MichalBlk/vvsoc/hw/top.sv

`include "isa.svh"
`include "evdev.svh"
`include "soc.svh"

module top
  import isa_pkg::*;
  import evdev_pkg::*;
  import param_pkg::*;
  import soc_pkg::*;
  import board_pkg::*;
(
  input  logic                      clk,
  input  logic                      vga_clk,
  input  logic                      nrst,

`ifdef NEXYS_A7
  input  logic                      dram_clk,
  input  logic                      fl_clk,
  input  logic                      kbd_clk,

  inout  logic [DDR2_DQLEN - 1:0]   ddr2_dq,
  inout  logic [DDR2_DQSLEN - 1:0]  ddr2_dqs_n,
  inout  logic [DDR2_DQSLEN - 1:0]  ddr2_dqs_p,
  output logic [DDR2_ADDRLEN - 1:0] ddr2_addr,
  output logic [DDR2_BALEN - 1:0]   ddr2_ba,
  output logic                      ddr2_ras_n,
  output logic                      ddr2_cas_n,
  output logic                      ddr2_we_n,
  output logic                      ddr2_ck_p,
  output logic                      ddr2_ck_n,
  output logic                      ddr2_cke,
  output logic                      ddr2_cs_n,
  output logic [DDR2_DMLEN - 1:0]   ddr2_dm,
  output logic                      ddr2_odt,

  input  logic                      fl_miso,
  output logic                      fl_mosi,
  output logic                      fl_sclk,
  output logic                      fl_ncs,

  input  logic                      kbd_data,
`endif

  input  logic                      rx,
  output logic                      tx,

  output logic [VGA_POSLEN - 1:0]   x,
  output logic [VGA_POSLEN - 1:0]   y,
  output logic [VGA_COLORLEN - 1:0] r,
  output logic [VGA_COLORLEN - 1:0] g,
  output logic [VGA_COLORLEN - 1:0] b,
  output logic                      hsync,
  output logic                      vsync
);
`default_nettype none

  logic [XLEN - 1:0]             bmem_asw_rdata;
  logic                          bmem_asw_stall;

  logic                          dbgc_asw_stall;
  logic [BLEN - 1:0]             dbgc_vmgr_byte;
  logic                          dbgc_vmgr_wen;

  logic [XLEN - 1:0]             clint_asw_rdata;
  logic [CNTLEN - 1:0]           clint_ac_mtime;
  logic                          clint_ac_intr_pending;

  logic [XLEN - 1:0]             fl_asw_rdata;
  logic                          fl_asw_stall;

  logic [XLEN - 1:0]             ac_asw_addr;
  logic [XLEN - 1:0]             ac_asw_wdata;
  logic [XLENB_LOG - 1:0]        ac_asw_size;
  logic                          ac_asw_nsign;
  logic                          ac_asw_ren;
  logic                          ac_asw_wen;

  logic [XLEN - 1:0]             asw_ac_rdata;
  logic                          asw_ac_stall;
  logic                          asw_ac_fault;
  logic [VCD_ADDRLEN - 1:0]      asw_vcd_addr;
  logic [XLEN - 1:0]             asw_vcd_wdata;
  logic                          asw_vcd_wen;
  logic [VGD_ADDRLEN - 1:0]      asw_vgd_addr;
  logic [XLEN - 1:0]             asw_vgd_wdata;
  logic                          asw_vgd_wen;
  logic [VKD_ADDRLEN - 1:0]      asw_vkd_addr;
  logic [XLEN - 1:0]             asw_vkd_wdata;
  logic                          asw_vkd_wen;
  logic [BMEM_ADDRLEN - 1:0]     asw_bmem_addr;
  logic [XLEN - 1:0]             asw_bmem_wdata;
  logic [XLENB_LOG - 1:0]        asw_bmem_size;
  logic                          asw_bmem_nsign;
  logic                          asw_bmem_ren;
  logic                          asw_bmem_wen;
  logic [BLEN - 1:0]             asw_dbgc_wdata;
  logic                          asw_dbgc_wen;
  logic [CLINT_ADDRLEN - 1:0]    asw_clint_addr;
  logic [XLEN - 1:0]             asw_clint_wdata;
  logic                          asw_clint_wen;
  logic [FL_ADDRLEN - 1:0]       asw_fl_addr;
  logic                          asw_fl_nsign;
  logic                          asw_fl_ren;
  logic [XLEN - 1:0]             asw_msw_addr;
  logic [XLEN - 1:0]             asw_msw_wdata;
  logic [XLENB_LOG - 1:0]        asw_msw_size;
  logic                          asw_msw_nsign;
  logic                          asw_msw_ren;
  logic                          asw_msw_wen;

  logic [XLEN - 1:0]             msw_asw_rdata;
  logic                          msw_asw_stall;
  logic [XLEN - 1:0]             msw_vsw_rdata;
  logic                          msw_vsw_stall;
  logic [MMEM_ADDRLEN - 1:0]     msw_cache_addr;
  logic [XLEN - 1:0]             msw_cache_wdata;
  logic [XLENB_LOG - 1:0]        msw_cache_size;
  logic                          msw_cache_nsign;
  logic                          msw_cache_ren;
  logic                          msw_cache_wen;

  logic [XLEN - 1:0]             cache_ac_pte;
  logic [CACHE_LINELEN - 1:0]    cache_ac_line;
  logic [XLEN - 1:0]             cache_msw_rdata;
  logic                          cache_msw_release;
  logic                          cache_msw_done;
  logic [MMEM_ADDRLEN - 1:0]     cache_mmem_addr;
  logic [MMEM_DATALEN - 1:0]     cache_mmem_wdata;
  logic                          cache_mmem_ren;
  logic                          cache_mmem_wen;

  logic [MMEM_DATALEN - 1:0]     mmem_cache_rdata;
  logic                          mmem_cache_stall;

  logic                          vcd_ac_intr_pending;
  logic [XLEN - 1:0]             vcd_asw_rdata;
  logic                          vcd_asw_stall;
  logic [XLEN - 1:0]             vcd_vsw_rdata;
  logic [VCD_QUEUECNT - 1:0]     vcd_vmgr_queue_rdy;
  logic [VCD_QUEUECNT_LOG - 1:0] vcd_vmgr_queue_num;
  logic                          vcd_vmgr_notify;
  logic                          vcd_vmgr_drvok;

  logic                          vgd_ac_intr_pending;
  logic [XLEN - 1:0]             vgd_asw_rdata;
  logic                          vgd_asw_stall;
  logic [XLEN - 1:0]             vgd_vsw_rdata;
  logic [VGD_QUEUECNT - 1:0]     vgd_vmgr_queue_rdy;
  logic [VGD_QUEUECNT_LOG - 1:0] vgd_vmgr_queue_num;
  logic                          vgd_vmgr_notify;
  logic                          vgd_vmgr_drvok;

  logic                          vkd_ac_intr_pending;
  logic [XLEN - 1:0]             vkd_asw_rdata;
  logic                          vkd_asw_stall;
  logic [XLEN - 1:0]             vkd_vsw_rdata;
  logic [VKD_QUEUECNT - 1:0]     vkd_vmgr_queue_rdy;
  logic [VKD_QUEUECNT_LOG - 1:0] vkd_vmgr_queue_num;
  logic                          vkd_vmgr_notify;
  logic                          vkd_vmgr_drvok;

  logic [XLEN - 1:0]             vsw_vc_rdata;
  logic                          vsw_vc_stall;
  logic [VMEM_ADDRLEN - 1:0]     vsw_vmem_addr;
  logic [XLEN - 1:0]             vsw_vmem_wdata;
  logic [XLENB_LOG - 1:0]        vsw_vmem_size;
  logic                          vsw_vmem_nsign;
  logic                          vsw_vmem_ren;
  logic                          vsw_vmem_wen;
  logic [VMGR_ADDRLEN - 1:0]     vsw_vmgr_addr;
  logic [XLEN - 1:0]             vsw_vmgr_wdata;
  logic                          vsw_vmgr_ren;
  logic                          vsw_vmgr_wen;
  logic [VCD_ADDRLEN - 1:0]      vsw_vcd_addr;
  logic [XLEN - 1:0]             vsw_vcd_wdata;
  logic                          vsw_vcd_wen;
  logic [VGD_ADDRLEN - 1:0]      vsw_vgd_addr;
  logic [XLEN - 1:0]             vsw_vgd_wdata;
  logic                          vsw_vgd_wen;
  logic [VKD_ADDRLEN - 1:0]      vsw_vkd_addr;
  logic [XLEN - 1:0]             vsw_vkd_wdata;
  logic                          vsw_vkd_wen;
  logic [XLEN - 1:0]             vsw_msw_addr;
  logic [XLEN - 1:0]             vsw_msw_wdata;
  logic [XLENB_LOG - 1:0]        vsw_msw_size;
  logic                          vsw_msw_nsign;
  logic                          vsw_msw_ren;
  logic                          vsw_msw_wen;

  logic [XLEN - 1:0]             vc_vsw_addr;
  logic [XLEN - 1:0]             vc_vsw_wdata;
  logic [XLENB_LOG - 1:0]        vc_vsw_size;
  logic                          vc_vsw_nsign;
  logic                          vc_vsw_ren;
  logic                          vc_vsw_wen;

  logic                          vmgr_dbgc_stall;
  logic [BLEN - 1:0]             vmgr_uart_tx_byte;
  logic                          vmgr_uart_tx_start;
  logic [VGA_COLORLEN - 1:0]     vmgr_vga_r;
  logic [VGA_COLORLEN - 1:0]     vmgr_vga_g;
  logic [VGA_COLORLEN - 1:0]     vmgr_vga_b;
  logic [XLEN - 1:0]             vmgr_vsw_rdata;
  logic                          vmgr_vsw_stall;
  logic                          vmgr_vcd_used;
  logic                          vmgr_vgd_used;
  logic                          vmgr_vkd_used;

  logic [XLEN - 1:0]             vmem_vsw_rdata;
  logic                          vmem_vsw_stall;
  logic [XLEN - 1:0]             vmem_vc_raw_data;

  logic [BLEN - 1:0]             uart_vmgr_rx_byte;
  logic                          uart_vmgr_rx_ready;
  logic                          uart_vmgr_tx_busy;

  logic [VGA_FRAMESZ_LOG - 1:0]  vga_vmgr_pos;

  logic [EV_CODELEN - 1:0]       kbd_vmgr_code;
  logic                          kbd_vmgr_value;
  logic                          kbd_vmgr_ready;

  dbg_console DBG_CONSOLE(
    .clk        (clk),
    .asw_wdata  (asw_dbgc_wdata),
    .asw_wen    (asw_dbgc_wen),
    .asw_stall  (dbgc_asw_stall),
    .vmgr_byte  (dbgc_vmgr_byte),
    .vmgr_wen   (dbgc_vmgr_wen),
    .vmgr_stall (vmgr_dbgc_stall)
  );

  memory #(
    .SZ    (BMEMSZ),
    .MEM   ("bootloader.mem")
  ) BOOT_MEMORY(
    .clk      (clk),
    .nrst     (nrst),
    .addr     (asw_bmem_addr),
    .wdata    (asw_bmem_wdata),
    .size     (asw_bmem_size),
    .nsign    (asw_bmem_nsign),
    .ren      (asw_bmem_ren),
    .wen      (asw_bmem_wen),
    .raw_data (),
    .rdata    (bmem_asw_rdata),
    .stall    (bmem_asw_stall)
  );

  clint CLINT(
    .clk             (clk),
    .nrst            (nrst),
    .asw_addr        (asw_clint_addr),
    .asw_wdata       (asw_clint_wdata),
    .asw_wen         (asw_clint_wen),
    .asw_rdata       (clint_asw_rdata),
    .ac_mtime        (clint_ac_mtime),
    .ac_intr_pending (clint_ac_intr_pending)
  );

`ifdef SIM
  flash FLASH(
    .clk       (clk),
    .nrst      (nrst),
    .asw_addr  (asw_fl_addr),
    .asw_nsign (asw_fl_nsign),
    .asw_ren   (asw_fl_ren),
    .asw_rdata (fl_asw_rdata),
    .asw_stall (fl_asw_stall)
  );
`elsif NEXYS_A7
  flash FLASH(
    .clk       (clk),
    .fl_clk    (fl_clk),
    .nrst      (nrst),
    .asw_addr  (asw_fl_addr),
    .asw_nsign (asw_fl_nsign),
    .asw_ren   (asw_fl_ren),
    .asw_rdata (fl_asw_rdata),
    .asw_stall (fl_asw_stall),
    .miso      (fl_miso),
    .mosi      (fl_mosi),
    .sclk      (fl_sclk),
    .ncs       (fl_ncs)
  );
`endif

  app_core APP_CORE(
    .clk                (clk),
    .nrst               (nrst),
    .clint_mtime        (clint_ac_mtime),
    .clint_intr_pending (clint_ac_intr_pending),
    .asw_rdata          (asw_ac_rdata),
    .asw_stall          (asw_ac_stall),
    .asw_fault          (asw_ac_fault),
    .asw_addr           (ac_asw_addr),
    .asw_wdata          (ac_asw_wdata),
    .asw_size           (ac_asw_size),
    .asw_nsign          (ac_asw_nsign),
    .asw_ren            (ac_asw_ren),
    .asw_wen            (ac_asw_wen),
    .cache_pte          (cache_ac_pte),
    .cache_line         (cache_ac_line),
    .vcd_intr_pending   (vcd_ac_intr_pending),
    .vgd_intr_pending   (vgd_ac_intr_pending),
    .vkd_intr_pending   (vkd_ac_intr_pending)
  );

  app_switch APP_SWITCH(
    .ac_addr     (ac_asw_addr),
    .ac_wdata    (ac_asw_wdata),
    .ac_size     (ac_asw_size),
    .ac_nsign    (ac_asw_nsign),
    .ac_ren      (ac_asw_ren),
    .ac_wen      (ac_asw_wen),
    .ac_rdata    (asw_ac_rdata),
    .ac_stall    (asw_ac_stall),
    .ac_fault    (asw_ac_fault),
    .vcd_rdata   (vcd_asw_rdata),
    .vcd_stall   (vcd_asw_stall),
    .vcd_addr    (asw_vcd_addr),
    .vcd_wdata   (asw_vcd_wdata),
    .vcd_wen     (asw_vcd_wen),
    .vgd_rdata   (vgd_asw_rdata),
    .vgd_stall   (vgd_asw_stall),
    .vgd_addr    (asw_vgd_addr),
    .vgd_wdata   (asw_vgd_wdata),
    .vgd_wen     (asw_vgd_wen),
    .vkd_rdata   (vkd_asw_rdata),
    .vkd_stall   (vkd_asw_stall),
    .vkd_addr    (asw_vkd_addr),
    .vkd_wdata   (asw_vkd_wdata),
    .vkd_wen     (asw_vkd_wen),
    .bmem_rdata  (bmem_asw_rdata),
    .bmem_stall  (bmem_asw_stall),
    .bmem_addr   (asw_bmem_addr),
    .bmem_wdata  (asw_bmem_wdata),
    .bmem_size   (asw_bmem_size),
    .bmem_nsign  (asw_bmem_nsign),
    .bmem_ren    (asw_bmem_ren),
    .bmem_wen    (asw_bmem_wen),
    .dbgc_stall  (dbgc_asw_stall),
    .dbgc_wdata  (asw_dbgc_wdata),
    .dbgc_wen    (asw_dbgc_wen),
    .clint_rdata (clint_asw_rdata),
    .clint_addr  (asw_clint_addr),
    .clint_wdata (asw_clint_wdata),
    .clint_wen   (asw_clint_wen),
    .fl_rdata    (fl_asw_rdata),
    .fl_stall    (fl_asw_stall),
    .fl_addr     (asw_fl_addr),
    .fl_nsign    (asw_fl_nsign),
    .fl_ren      (asw_fl_ren),
    .msw_rdata   (msw_asw_rdata),
    .msw_stall   (msw_asw_stall),
    .msw_addr    (asw_msw_addr),
    .msw_wdata   (asw_msw_wdata),
    .msw_size    (asw_msw_size),
    .msw_nsign   (asw_msw_nsign),
    .msw_ren     (asw_msw_ren),
    .msw_wen     (asw_msw_wen)
  );

  main_switch MAIN_SWITCH(
    .clk           (clk),
    .nrst          (nrst),
    .asw_addr      (asw_msw_addr),
    .asw_wdata     (asw_msw_wdata),
    .asw_size      (asw_msw_size),
    .asw_nsign     (asw_msw_nsign),
    .asw_ren       (asw_msw_ren),
    .asw_wen       (asw_msw_wen),
    .asw_rdata     (msw_asw_rdata),
    .asw_stall     (msw_asw_stall),
    .vsw_addr      (vsw_msw_addr),
    .vsw_wdata     (vsw_msw_wdata),
    .vsw_size      (vsw_msw_size),
    .vsw_nsign     (vsw_msw_nsign),
    .vsw_ren       (vsw_msw_ren),
    .vsw_wen       (vsw_msw_wen),
    .vsw_rdata     (msw_vsw_rdata),
    .vsw_stall     (msw_vsw_stall),
    .cache_rdata   (cache_msw_rdata),
    .cache_release (cache_msw_release),
    .cache_done    (cache_msw_done),
    .cache_addr    (msw_cache_addr),
    .cache_wdata   (msw_cache_wdata),
    .cache_size    (msw_cache_size),
    .cache_nsign   (msw_cache_nsign),
    .cache_ren     (msw_cache_ren),
    .cache_wen     (msw_cache_wen)
  );

  cache CACHE(
    .clk         (clk),
    .nrst        (nrst),
    .ac_pte      (cache_ac_pte),
    .ac_line     (cache_ac_line),
    .msw_addr    (msw_cache_addr),
    .msw_wdata   (msw_cache_wdata),
    .msw_size    (msw_cache_size),
    .msw_nsign   (msw_cache_nsign),
    .msw_ren     (msw_cache_ren),
    .msw_wen     (msw_cache_wen),
    .msw_rdata   (cache_msw_rdata),
    .msw_release (cache_msw_release),
    .msw_done    (cache_msw_done),
    .mmem_rdata  (mmem_cache_rdata),
    .mmem_stall  (mmem_cache_stall),
    .mmem_addr   (cache_mmem_addr),
    .mmem_wdata  (cache_mmem_wdata),
    .mmem_ren    (cache_mmem_ren),
    .mmem_wen    (cache_mmem_wen)
  );

`ifdef SIM
  main_memory MAIN_MEMORY(
    .clk         (clk),
    .nrst        (nrst),
    .cache_addr  (cache_mmem_addr),
    .cache_wdata (cache_mmem_wdata),
    .cache_ren   (cache_mmem_ren),
    .cache_wen   (cache_mmem_wen),
    .cache_rdata (mmem_cache_rdata),
    .cache_stall (mmem_cache_stall)
  );
`elsif NEXYS_A7
  main_memory MAIN_MEMORY(
    .clk         (clk),
    .dram_clk    (dram_clk),
    .nrst        (nrst),
    .cache_addr  (cache_mmem_addr),
    .cache_wdata (cache_mmem_wdata),
    .cache_ren   (cache_mmem_ren),
    .cache_wen   (cache_mmem_wen),
    .cache_rdata (mmem_cache_rdata),
    .cache_stall (mmem_cache_stall),
    .ddr2_addr   (ddr2_addr),
    .ddr2_ba     (ddr2_ba),
    .ddr2_cas_n  (ddr2_cas_n),
    .ddr2_ck_n   (ddr2_ck_n),
    .ddr2_ck_p   (ddr2_ck_p),
    .ddr2_cke    (ddr2_cke),
    .ddr2_ras_n  (ddr2_ras_n),
    .ddr2_we_n   (ddr2_we_n),
    .ddr2_dq     (ddr2_dq),
    .ddr2_dqs_n  (ddr2_dqs_n),
    .ddr2_dqs_p  (ddr2_dqs_p),
    .ddr2_cs_n   (ddr2_cs_n),
    .ddr2_dm     (ddr2_dm),
    .ddr2_odt    (ddr2_odt)
  );
`endif

  virtio_console_dev VIRTIO_CONSOLE_DEV(
    .clk             (clk),
    .nrst            (nrst),
    .ac_intr_pending (vcd_ac_intr_pending),
    .asw_addr        (asw_vcd_addr),
    .asw_wdata       (asw_vcd_wdata),
    .asw_wen         (asw_vcd_wen),
    .asw_rdata       (vcd_asw_rdata),
    .asw_stall       (vcd_asw_stall),
    .vsw_addr        (vsw_vcd_addr),
    .vsw_wdata       (vsw_vcd_wdata),
    .vsw_wen         (vsw_vcd_wen),
    .vsw_rdata       (vcd_vsw_rdata),
    .vmgr_used       (vmgr_vcd_used),
    .vmgr_queue_rdy  (vcd_vmgr_queue_rdy),
    .vmgr_queue_num  (vcd_vmgr_queue_num),
    .vmgr_notify     (vcd_vmgr_notify),
    .vmgr_drvok      (vcd_vmgr_drvok)
  );

  virtio_gpu_dev VIRTIO_GPU_DEV(
    .clk             (clk),
    .nrst            (nrst),
    .ac_intr_pending (vgd_ac_intr_pending),
    .asw_addr        (asw_vgd_addr),
    .asw_wdata       (asw_vgd_wdata),
    .asw_wen         (asw_vgd_wen),
    .asw_rdata       (vgd_asw_rdata),
    .asw_stall       (vgd_asw_stall),
    .vsw_addr        (vsw_vgd_addr),
    .vsw_wdata       (vsw_vgd_wdata),
    .vsw_wen         (vsw_vgd_wen),
    .vsw_rdata       (vgd_vsw_rdata),
    .vmgr_used       (vmgr_vgd_used),
    .vmgr_queue_rdy  (vgd_vmgr_queue_rdy),
    .vmgr_queue_num  (vgd_vmgr_queue_num),
    .vmgr_notify     (vgd_vmgr_notify),
    .vmgr_drvok      (vgd_vmgr_drvok)
  );

  virtio_kbd_dev VIRTIO_KBD_DEV(
    .clk             (clk),
    .nrst            (nrst),
    .ac_intr_pending (vkd_ac_intr_pending),
    .asw_addr        (asw_vkd_addr),
    .asw_wdata       (asw_vkd_wdata),
    .asw_wen         (asw_vkd_wen),
    .asw_rdata       (vkd_asw_rdata),
    .asw_stall       (vkd_asw_stall),
    .vsw_addr        (vsw_vkd_addr),
    .vsw_wdata       (vsw_vkd_wdata),
    .vsw_wen         (vsw_vkd_wen),
    .vsw_rdata       (vkd_vsw_rdata),
    .vmgr_used       (vmgr_vkd_used),
    .vmgr_queue_rdy  (vkd_vmgr_queue_rdy),
    .vmgr_queue_num  (vkd_vmgr_queue_num),
    .vmgr_notify     (vkd_vmgr_notify),
    .vmgr_drvok      (vkd_vmgr_drvok)
  );

  virtio_switch VIRTIO_SWITCH(
    .vc_addr    (vc_vsw_addr),
    .vc_wdata   (vc_vsw_wdata),
    .vc_size    (vc_vsw_size),
    .vc_nsign   (vc_vsw_nsign),
    .vc_ren     (vc_vsw_ren),
    .vc_wen     (vc_vsw_wen),
    .vc_rdata   (vsw_vc_rdata),
    .vc_stall   (vsw_vc_stall),
    .vmem_rdata (vmem_vsw_rdata),
    .vmem_stall (vmem_vsw_stall),
    .vmem_addr  (vsw_vmem_addr),
    .vmem_wdata (vsw_vmem_wdata),
    .vmem_size  (vsw_vmem_size),
    .vmem_nsign (vsw_vmem_nsign),
    .vmem_ren   (vsw_vmem_ren),
    .vmem_wen   (vsw_vmem_wen),
    .vmgr_rdata (vmgr_vsw_rdata),
    .vmgr_stall (vmgr_vsw_stall),
    .vmgr_addr  (vsw_vmgr_addr),
    .vmgr_wdata (vsw_vmgr_wdata),
    .vmgr_ren   (vsw_vmgr_ren),
    .vmgr_wen   (vsw_vmgr_wen),
    .vcd_rdata  (vcd_vsw_rdata),
    .vcd_addr   (vsw_vcd_addr),
    .vcd_wdata  (vsw_vcd_wdata),
    .vcd_wen    (vsw_vcd_wen),
    .vgd_rdata  (vgd_vsw_rdata),
    .vgd_addr   (vsw_vgd_addr),
    .vgd_wdata  (vsw_vgd_wdata),
    .vgd_wen    (vsw_vgd_wen),
    .vkd_rdata  (vkd_vsw_rdata),
    .vkd_addr   (vsw_vkd_addr),
    .vkd_wdata  (vsw_vkd_wdata),
    .vkd_wen    (vsw_vkd_wen),
    .msw_rdata  (msw_vsw_rdata),
    .msw_stall  (msw_vsw_stall),
    .msw_addr   (vsw_msw_addr),
    .msw_wdata  (vsw_msw_wdata),
    .msw_size   (vsw_msw_size),
    .msw_nsign  (vsw_msw_nsign),
    .msw_ren    (vsw_msw_ren),
    .msw_wen    (vsw_msw_wen)
  );

  virtio_core VIRTIO_CORE(
    .clk           (clk),
    .nrst          (nrst),
    .vsw_rdata     (vsw_vc_rdata),
    .vsw_stall     (vsw_vc_stall),
    .vsw_addr      (vc_vsw_addr),
    .vsw_wdata     (vc_vsw_wdata),
    .vsw_size      (vc_vsw_size),
    .vsw_nsign     (vc_vsw_nsign),
    .vsw_ren       (vc_vsw_ren),
    .vsw_wen       (vc_vsw_wen),
    .vmem_raw_data (vmem_vc_raw_data)
  );

  virtio_manager VIRTIO_MANAGER(
    .clk           (clk),
    .nrst          (nrst),
    .dbgc_byte     (dbgc_vmgr_byte),
    .dbgc_wen      (dbgc_vmgr_wen),
    .dbgc_stall    (vmgr_dbgc_stall),
    .uart_rx_byte  (uart_vmgr_rx_byte),
    .uart_rx_ready (uart_vmgr_rx_ready),
    .uart_tx_busy  (uart_vmgr_tx_busy),
    .uart_tx_byte  (vmgr_uart_tx_byte),
    .uart_tx_start (vmgr_uart_tx_start),
    .vga_pos       (vga_vmgr_pos),
    .vga_r         (vmgr_vga_r),
    .vga_g         (vmgr_vga_g),
    .vga_b         (vmgr_vga_b),
    .kbd_code      (kbd_vmgr_code),
    .kbd_value     (kbd_vmgr_value),
    .kbd_ready     (kbd_vmgr_ready),
    .vsw_addr      (vsw_vmgr_addr),
    .vsw_wdata     (vsw_vmgr_wdata),
    .vsw_ren       (vsw_vmgr_ren),
    .vsw_wen       (vsw_vmgr_wen),
    .vsw_rdata     (vmgr_vsw_rdata),
    .vsw_stall     (vmgr_vsw_stall),
    .vcd_queue_rdy (vcd_vmgr_queue_rdy),
    .vcd_queue_num (vcd_vmgr_queue_num),
    .vcd_drvok     (vcd_vmgr_drvok),
    .vcd_notify    (vcd_vmgr_notify),
    .vcd_used      (vmgr_vcd_used),
    .vgd_queue_rdy (vgd_vmgr_queue_rdy),
    .vgd_queue_num (vgd_vmgr_queue_num),
    .vgd_drvok     (vgd_vmgr_drvok),
    .vgd_notify    (vgd_vmgr_notify),
    .vgd_used      (vmgr_vgd_used),
    .vkd_queue_rdy (vkd_vmgr_queue_rdy),
    .vkd_queue_num (vkd_vmgr_queue_num),
    .vkd_drvok     (vkd_vmgr_drvok),
    .vkd_notify    (vkd_vmgr_notify),
    .vkd_used      (vmgr_vkd_used)
  );

  memory #(
    .SZ    (VMEMSZ),
    .MEM   ("virtio.mem")
  ) VIRTIO_MEMORY(
    .clk      (clk),
    .nrst     (nrst),
    .addr     (vsw_vmem_addr),
    .wdata    (vsw_vmem_wdata),
    .size     (vsw_vmem_size),
    .nsign    (vsw_vmem_nsign),
    .ren      (vsw_vmem_ren),
    .wen      (vsw_vmem_wen),
    .raw_data (vmem_vc_raw_data),
    .rdata    (vmem_vsw_rdata),
    .stall    (vmem_vsw_stall)
  );

  uart UART(
    .clk           (clk),
    .nrst          (nrst),
    .rx            (rx),
    .tx            (tx),
    .vmgr_tx_byte  (vmgr_uart_tx_byte),
    .vmgr_tx_start (vmgr_uart_tx_start),
    .vmgr_rx_byte  (uart_vmgr_rx_byte),
    .vmgr_rx_ready (uart_vmgr_rx_ready),
    .vmgr_tx_busy  (uart_vmgr_tx_busy)
  );

  vga VGA(
    .vga_clk  (vga_clk),
    .nrst     (nrst),
    .x        (x),
    .y        (y),
    .r        (r),
    .g        (g),
    .b        (b),
    .hsync    (hsync),
    .vsync    (vsync),
    .vmgr_r   (vmgr_vga_r),
    .vmgr_g   (vmgr_vga_g),
    .vmgr_b   (vmgr_vga_b),
    .vmgr_pos (vga_vmgr_pos)
  );

`ifdef NEXYS_A7
  kbd KBD(
    .clk        (clk),
    .kbd_clk    (kbd_clk),
    .nrst       (nrst),
    .kbd_data   (kbd_data),
    .vmgr_code  (kbd_vmgr_code),
    .vmgr_value (kbd_vmgr_value),
    .vmgr_ready (kbd_vmgr_ready)
  );
`endif
endmodule
