MichalBlk/vvsoc/hw/app/app_core/app_core.sv

`include "isa.svh"
`include "soc.svh"

module app_core
  import isa_pkg::*;
  import param_pkg::*;
  import soc_pkg::*;
(
  input  logic                       clk,
  input  logic                       nrst,

  input  logic [CNTLEN - 1:0]        clint_mtime,
  input  logic                       clint_intr_pending,

  input  logic [XLEN - 1:0]          asw_rdata,
  input  logic                       asw_stall,
  input  logic                       asw_fault,
  output logic [XLEN - 1:0]          asw_addr,
  output logic [XLEN - 1:0]          asw_wdata,
  output logic [XLENB_LOG - 1:0]     asw_size,
  output logic                       asw_nsign,
  output logic                       asw_ren,
  output logic                       asw_wen,

  input  logic [XLEN - 1:0]          cache_pte,
  input  logic [CACHE_LINELEN - 1:0] cache_line,

  input  logic                       vcd_intr_pending,

  input  logic                       vgd_intr_pending,

  input  logic                       vkd_intr_pending
);
`default_nettype none

  typedef enum logic [2:0] {
    ST_IF_DEC,
    ST_EXE1,
    ST_MEM1,
    ST_EXE2,
    ST_MEM2,
    ST_COM,
    ST_MISALIGNED_JMP
  } state_t;

  state_t                  state, state_r;
  logic [XLEN - 1:0]       pc, pc_r;
  logic [XLEN - 1:0]       resv_addr, resv_addr_r;
  logic                    resv_valid, resv_valid_r;

  logic                    bclint_intr_pending, bclint_intr_pending_r;
  logic                    bvcd_intr_pending, bvcd_intr_pending_r;
  logic                    bvgd_intr_pending, bvgd_intr_pending_r;
  logic                    bvkd_intr_pending, bvkd_intr_pending_r;

  logic [ILEN - 1:0]       inst, inst_r;
  logic [OPCODELEN - 1:0]  _opcode;
  logic [OPCODELEN - 1:0]  opcode;
  logic [REGCNT_LOG - 1:0] rd;
  logic [FUNCT3LEN - 1:0]  funct3;
  logic [FUNCT5LEN - 1:0]  _funct5;
  logic [FUNCT5LEN - 1:0]  funct5;
  logic [FUNCT7LEN - 1:0]  funct7;
  logic [FUNCT12LEN - 1:0] funct12;
  logic [XLENB_LOG - 1:0]  mem_size;
  logic [XLEN - 1:0]       imm, imm_r;
  logic [XLEN - 1:0]       rs1_data, rs1_data_r;
  logic [XLEN - 1:0]       rs2_data, rs2_data_r;
  logic [XLEN - 1:0]       csr_rdata, csr_rdata_r;
  logic [XLEN - 1:0]       csr_wdata, csr_wdata_r;
  logic [XLEN - 1:0]       rd_data, rd_data_r;
  logic [XLEN - 1:0]       mem_addr, mem_addr_r;
  logic [XLEN - 1:0]       amo_rmw_data, amo_rmw_data_r;
  logic [XLEN - 1:0]       nxt_pc, nxt_pc_r;
  logic [XLEN - 1:0]       off_pc, off_pc_r;
  logic [XLEN - 1:0]       reg_pc, reg_pc_r;
  logic [XLEN - 1:0]       jmp_pc;
  logic                    fencei, fencei_r;
  logic                    mul, mul_r;
  logic                    div, div_r;
  logic                    ecall, ecall_r;
  logic                    ebreak, ebreak_r;
  logic                    mret, mret_r;
  logic                    sret, sret_r;
  logic                    sfence_vma, sfence_vma_r;
  logic                    tkn;
  logic                    amo_sc_succ;
  logic                    load_amo_lr, load_amo_lr_r;
  logic                    store_amo_sc_succ;
  logic                    amo_rmw, amo_rmw_r;
  logic [XLEN - 1:0]       mem_data, mem_data_r;
  exc_t                    exc_code, exc_code_r;
  logic                    exc_pending, exc_pending_r;
  logic                    if_dec_exc_pending;
  logic                    exe_exc_pending;
  logic                    misaligned_mem_access;
  logic                    misaligned_jmp;
  logic [XLEN - 1:0]       tval, tval_r;

  logic                    iv_nop;
  logic                    iv_fencei;
  logic                    iv_mret;
  logic                    iv_sret;
  logic                    iv_sfence_vma;
  logic                    iv_valid;

  logic [XLEN - 1:0]       rf_wdata;
  logic                    rf_wen;

  logic [XLEN - 1:0]       csrrf_target_pc;
  logic                    csrrf_rcsr;
  logic                    csrrf_wcsr;
  logic                    csrrf_com;
  priv_t                   csrrf_priv;
  logic [XLEN - 1:0]       csrrf_mstatus;
  logic [XLEN - 1:0]       csrrf_satp;
  logic                    csrrf_ill;
  logic [XLEN - 1:0]       csrrf_tvec;
  logic                    csrrf_intr_handling;
  logic                    csrrf_chg_priv;

  logic                    mul_stall;

  logic                    div_stall;

  logic                    bralu_res;

  logic                    mmu_tlb_flush;
  logic                    mmu_icache_flush;
  logic [XLEN - 1:0]       mmu_rdata;
  logic [XLEN - 1:0]       mmu_inst;
  exc_t                    mmu_exc_code;
  logic                    mmu_exc_pending;
  logic                    mmu_stall;

  /*
   * Input buffering
   */
  always_comb begin
    bclint_intr_pending = bclint_intr_pending_r;
    bvcd_intr_pending   = bvcd_intr_pending_r;
    bvgd_intr_pending   = bvgd_intr_pending_r;
    bvkd_intr_pending   = bvkd_intr_pending_r;

    if (state_r == ST_IF_DEC) begin
      bclint_intr_pending = clint_intr_pending;
      bvcd_intr_pending   = vcd_intr_pending;
      bvgd_intr_pending   = vgd_intr_pending;
      bvkd_intr_pending   = vkd_intr_pending;
    end
  end

  always_ff @(posedge clk) begin
    bclint_intr_pending_r <= bclint_intr_pending;
    bvcd_intr_pending_r   <= bvcd_intr_pending;
    bvgd_intr_pending_r   <= bvgd_intr_pending;
    bvkd_intr_pending_r   <= bvkd_intr_pending;
  end

  /*
   * Instruction fetch and decode stage
   */
  logic [REGCNT_LOG - 1:0] _rs1;
  logic [REGCNT_LOG - 1:0] _rs2;
  logic [FUNCT3LEN - 1:0]  _funct3;
  logic [FUNCT7LEN - 1:0]  _funct7;
  logic [FUNCT12LEN - 1:0] _funct12;
  logic [XLEN - 1:0]       rf_rdata1;
  logic [XLEN - 1:0]       rf_rdata2;
  logic [XLEN - 1:0]       ig_imm;
  csr_addr_t               csrrf_addr;
  logic                    csrrf_mret;
  logic                    csrrf_sret;
  logic [XLEN - 1:0]       csrrf_rdata;
  logic                    iv_mul;
  logic                    iv_div;
  logic                    iv_ecall;
  logic                    iv_ebreak;
  logic                    fence;
  logic                    wfi;

  assign _opcode  = mmu_inst[OPCODESH+:OPCODELEN];
  assign _rs1     = mmu_inst[RS1SH+:REGCNT_LOG];
  assign _rs2     = mmu_inst[RS2SH+:REGCNT_LOG];
  assign _funct3  = mmu_inst[FUNCT3SH+:FUNCT3LEN];
  assign _funct5  = mmu_inst[FUNCT5SH+:FUNCT5LEN];
  assign _funct7  = mmu_inst[FUNCT7SH+:FUNCT7LEN];
  assign _funct12 = mmu_inst[FUNCT12SH+:FUNCT12LEN];

  inst_verifier INST_VERIFIER(
    .ac_opcode     (_opcode),
    .ac_funct3     (_funct3),
    .ac_funct5     (_funct5),
    .ac_funct7     (_funct7),
    .ac_funct12    (_funct12),
    .ac_nop        (iv_nop),
    .ac_fencei     (iv_fencei),
    .ac_mul        (iv_mul),
    .ac_div        (iv_div),
    .ac_ecall      (iv_ecall),
    .ac_ebreak     (iv_ebreak),
    .ac_mret       (iv_mret),
    .ac_sret       (iv_sret),
    .ac_sfence_vma (iv_sfence_vma),
    .ac_valid      (iv_valid)
  );

  reg_file #(
    .RSTARG  (0)
  ) REG_FILE(
    .clk     (clk),
    .nrst    (nrst),
    .raddr1  (_rs1),
    .raddr2  (_rs2),
    .waddr   (rd),
    .wdata   (rf_wdata),
    .wen     (rf_wen),
    .rdata1  (rf_rdata1),
    .rdata2  (rf_rdata2)
  );

  assign csrrf_addr = state_r == ST_IF_DEC ? csr_addr_t'(_funct12) : csr_addr_t'(funct12);
  assign csrrf_rcsr = _opcode == OPCODE_SYSTEM && _funct3 != FUNCT3_PRIV;
  assign csrrf_mret = state_r == ST_IF_DEC ? iv_mret : mret_r;
  assign csrrf_sret = state_r == ST_IF_DEC ? iv_sret : sret_r;

  csr_reg_file CSR_REG_FILE(
    .clk                (clk),
    .nrst               (nrst),
    .ac_addr            (csrrf_addr),
    .ac_wdata           (csr_wdata_r),
    .ac_pc              (pc_r),
    .ac_target_pc       (csrrf_target_pc),
    .ac_exc_code        (exc_code_r),
    .ac_exc_pending     (exc_pending_r),
    .ac_tval            (tval_r),
    .ac_rcsr            (csrrf_rcsr),
    .ac_wcsr            (csrrf_wcsr),
    .ac_mret            (csrrf_mret),
    .ac_sret            (csrrf_sret),
    .ac_com             (csrrf_com),
    .ac_mtime           (clint_mtime),
    .ac_rdata           (csrrf_rdata),
    .ac_priv            (csrrf_priv),
    .ac_mstatus         (csrrf_mstatus),
    .ac_satp            (csrrf_satp),
    .ac_ill             (csrrf_ill),
    .ac_tvec            (csrrf_tvec),
    .ac_intr_handling   (csrrf_intr_handling),
    .ac_chg_priv        (csrrf_chg_priv),
    .clint_intr_pending (bclint_intr_pending_r),
    .vcd_intr_pending   (bvcd_intr_pending_r),
    .vgd_intr_pending   (bvgd_intr_pending_r),
    .vkd_intr_pending   (bvkd_intr_pending_r)
  );

  imm_gen IMM_GEN(
    .inst (mmu_inst),
    .imm  (ig_imm)
  );

  always_comb begin
    inst        = inst_r;
    imm         = imm_r;
    rs1_data    = rs1_data_r;
    rs2_data    = rs2_data_r;
    csr_rdata   = csr_rdata_r;
    mem_addr    = mem_addr_r;
    nxt_pc      = nxt_pc_r;
    off_pc      = off_pc_r;
    reg_pc      = reg_pc_r;
    fencei      = fencei_r;
    mul         = mul_r;
    div         = div_r;
    ecall       = ecall_r;
    ebreak      = ebreak_r;
    mret        = mret_r;
    sret        = sret_r;
    sfence_vma  = sfence_vma_r;
    load_amo_lr = load_amo_lr_r;
    amo_rmw     = amo_rmw_r;

    if (state_r == ST_IF_DEC) begin
      inst        = iv_nop ? NOP : mmu_inst;
      imm         = ig_imm;
      rs1_data    = rf_rdata1;
      rs2_data    = rf_rdata2;
      csr_rdata   = csrrf_rdata;
      mem_addr    = rf_rdata1 + (_opcode == OPCODE_AMO ? 0 : ig_imm);
      nxt_pc      = pc_r + ILENB;
      off_pc      = pc_r + ig_imm;
      reg_pc      = rf_rdata1 + ig_imm;
      fencei      = iv_fencei;
      mul         = iv_mul;
      ecall       = iv_ecall;
      ebreak      = iv_ebreak;
      mret        = iv_mret;
      sret        = iv_sret;
      div         = iv_div;
      sfence_vma  = iv_sfence_vma;
      load_amo_lr = _opcode == OPCODE_LOAD ||
        (_opcode == OPCODE_AMO && _funct5 == FUNCT5_AMO_LR);
      amo_rmw     = _opcode == OPCODE_AMO &&
        _funct5 != FUNCT5_AMO_LR && _funct5 != FUNCT5_AMO_SC;
    end
  end

  always_ff @(posedge clk) begin
    inst_r        <= inst;
    imm_r         <= imm;
    rs1_data_r    <= rs1_data;
    rs2_data_r    <= rs2_data;
    csr_rdata_r   <= csr_rdata;
    mem_addr_r    <= mem_addr;
    nxt_pc_r      <= nxt_pc;
    off_pc_r      <= off_pc;
    reg_pc_r      <= reg_pc;
    fencei_r      <= fencei;
    mul_r         <= mul;
    div_r         <= div;
    ecall_r       <= ecall;
    ebreak_r      <= ebreak;
    mret_r        <= mret;
    sret_r        <= sret;
    sfence_vma_r  <= sfence_vma;
    load_amo_lr_r <= load_amo_lr;
    amo_rmw_r     <= amo_rmw;
  end

  /*
   * Execute stage 1
   */
  logic [XLEN - 1:0] csralu_res;
  logic              mul_start;
  logic [XLEN - 1:0] mul_res;
  logic              div_start;
  logic [XLEN - 1:0] div_res;

  assign opcode            = inst_r[OPCODESH+:OPCODELEN];
  assign rd                = inst_r[RDSH+:REGCNT_LOG];
  assign funct3            = inst_r[FUNCT3SH+:FUNCT3LEN];
  assign funct5            = inst_r[FUNCT5SH+:FUNCT5LEN];
  assign funct7            = inst_r[FUNCT7SH+:FUNCT7LEN];
  assign funct12           = inst_r[FUNCT12SH+:FUNCT12LEN];

  assign mem_size          = funct3[FUNCT3_SIZESH+:XLENB_LOG];

  assign amo_sc_succ       = rs1_data_r == resv_addr_r && resv_valid_r;
  assign store_amo_sc_succ = opcode == OPCODE_STORE ||
    (opcode == OPCODE_AMO && funct5 == FUNCT5_AMO_SC && amo_sc_succ);

  csr_alu CSR_ALU(
    .ac_csr    (csr_rdata_r),
    .ac_src    (rs1_data_r),
    .ac_imm    (imm_r),
    .ac_funct3 (funct3),
    .ac_res    (csralu_res)
  );

  assign mul_start = state_r == ST_EXE1 && mul_r;

  multiplier MULTIPLIER(
    .clk       (clk),
    .nrst      (nrst),
    .ac_src1   (rs1_data_r),
    .ac_src2   (rs2_data_r),
    .ac_funct3 (funct3),
    .ac_start  (mul_start),
    .ac_res    (mul_res),
    .ac_stall  (mul_stall)
  );

  assign div_start = state_r == ST_EXE1 && div_r;

  divisor DIVISOR(
    .clk       (clk),
    .nrst      (nrst),
    .ac_src1   (rs1_data_r),
    .ac_src2   (rs2_data_r),
    .ac_funct3 (funct3),
    .ac_start  (div_start),
    .ac_res    (div_res),
    .ac_stall  (div_stall)
  );

  always_comb begin
    csr_wdata = csr_wdata_r;
    rd_data   = rd_data_r;

    if (state_r == ST_EXE1) begin
      csr_wdata = csralu_res;

      unique0 case (opcode)
        OPCODE_OP:  rd_data = mul_r ? mul_res : div_res;
        OPCODE_AMO: rd_data = !amo_sc_succ;
      endcase
    end
  end

  always_ff @(posedge clk) begin
    csr_wdata_r <= csr_wdata;
    rd_data_r   <= rd_data;
  end

  /*
   * Memory stage 1
   */
  always_comb begin
    mem_data = mem_data_r;

    if (state_r == ST_MEM1)
      mem_data = mmu_rdata;
  end

  always_ff @(posedge clk)
    mem_data_r <= mem_data;

  /*
   * Execute stage 2
   */
  logic [XLEN - 1:0] amo_alu_res;

  amo_alu AMO_ALU(
    .ac_src1   (rs2_data_r),
    .ac_src2   (mem_data_r),
    .ac_funct5 (funct5),
    .ac_res    (amo_alu_res)
  );

  always_comb begin
    amo_rmw_data = amo_rmw_data_r;

    if (state_r == ST_EXE2)
      amo_rmw_data = amo_alu_res;
  end

  always_ff @(posedge clk)
    amo_rmw_data_r <= amo_rmw_data;

  /*
   * Completion stage
   */
  logic [XLEN - 1:0]      opalu_src2;
  logic [FUNCT7LEN - 1:0] opalu_funct7;
  logic [XLEN - 1:0]      opalu_res;

  assign opalu_src2   = opcode == OPCODE_OP_IMM ? imm_r : rs2_data_r;
  assign opalu_funct7 = opcode != OPCODE_OP_IMM || funct3 == FUNCT3_SRA ? funct7 : 0;

  op_alu OP_ALU(
    .src1   (rs1_data_r),
    .src2   (opalu_src2),
    .funct3 (funct3),
    .funct7 (opalu_funct7),
    .res    (opalu_res)
  );

  branch_alu BRANCH_ALU(
    .src1   (rs1_data_r),
    .src2   (rs2_data_r),
    .funct3 (funct3),
    .res    (bralu_res)
  );

  always_comb begin
    rf_wdata = rd_data_r;

    unique0 if (load_amo_lr_r || amo_rmw_r)
      rf_wdata = mem_data_r;
    else if (opcode == OPCODE_LUI)
      rf_wdata = imm_r;
    else if (opcode == OPCODE_AUIPC)
      rf_wdata = off_pc_r;
    else if (opcode == OPCODE_JAL || opcode == OPCODE_JALR)
      rf_wdata = nxt_pc_r;
    else if (opcode == OPCODE_OP_IMM || (opcode == OPCODE_OP && !mul_r && !div_r))
      rf_wdata = opalu_res;
    else if (opcode == OPCODE_SYSTEM)
      rf_wdata = csr_rdata_r;
  end

  assign rf_wen = ((state_r == ST_COM && !exc_pending_r && !misaligned_jmp) ||
    state_r == ST_MISALIGNED_JMP) &&
    (opcode == OPCODE_LUI || opcode == OPCODE_AUIPC || opcode == OPCODE_JAL ||
     opcode == OPCODE_JALR || opcode == OPCODE_LOAD || opcode == OPCODE_OP_IMM ||
     opcode == OPCODE_OP || opcode == OPCODE_AMO ||
     (opcode == OPCODE_SYSTEM && funct3 != FUNCT3_PRIV));

  assign csrrf_target_pc = tkn ? jmp_pc : nxt_pc_r;
  assign csrrf_wcsr      = opcode == OPCODE_SYSTEM && funct3 != FUNCT3_PRIV;
  assign csrrf_com       = (state_r == ST_COM && !misaligned_jmp) ||
    state_r == ST_MISALIGNED_JMP;

  always_comb begin
    resv_addr  = resv_addr_r;
    resv_valid = resv_valid_r;

    if (state_r == ST_COM && opcode == OPCODE_AMO) begin
      unique0 if (funct5 == FUNCT5_AMO_SC)
        resv_valid = 0;
      else if (funct5 == FUNCT5_AMO_LR) begin
        resv_addr  = mem_addr_r;
        resv_valid = 1;
      end
    end
  end

  always_ff @(posedge clk, negedge nrst)
    if (!nrst)
      resv_valid_r <= 0;
    else begin
      resv_addr_r  <= resv_addr;
      resv_valid_r <= resv_valid;
    end

  always_comb begin
    jmp_pc = 'bx;
    tkn    = 0;

    case (opcode)
      OPCODE_JAL: begin
        jmp_pc = off_pc_r;
        tkn    = 1;
      end

      OPCODE_JALR: begin
        jmp_pc = reg_pc_r;
        tkn    = 1;
      end

      OPCODE_BRANCH: begin
        jmp_pc = off_pc_r;
        tkn    = bralu_res;
      end

      OPCODE_SYSTEM:
        if (mret_r || sret_r) begin
          jmp_pc = csr_rdata_r;
          tkn    = 1;
        end
    endcase
  end

  assign mmu_tlb_flush    = state_r == ST_COM && sfence_vma_r;
  assign mmu_icache_flush = (state_r == ST_COM &&
    (fencei_r || sfence_vma_r || csrrf_chg_priv ||
    (csrrf_wcsr && csrrf_addr == CSR_SATP))) || state_r == ST_MISALIGNED_JMP;

  /*
   * Program counter handling
   */
  always_comb begin
    pc = pc_r;

    case (state_r)
      ST_COM:
        pc = exc_pending_r || csrrf_intr_handling ? csrrf_tvec : csrrf_target_pc;

      ST_MISALIGNED_JMP:
        pc = csrrf_tvec;
    endcase
  end

  always_ff @(posedge clk, negedge nrst)
    if (!nrst)
      pc_r <= AC_RESET_PC;
    else
      pc_r <= pc;

  /*
   * Exception detection
   */
  logic ill_inst;

  assign ill_inst              = !iv_valid || (iv_mret && csrrf_priv != PRIV_M) ||
    ((iv_sret || iv_sfence_vma) && csrrf_priv == PRIV_U);

  assign misaligned_mem_access = (mem_addr_r & ((1 << mem_size) - 1)) != 0;
  assign misaligned_jmp        = tkn && jmp_pc[ILENB_LOG - 1:0];

  assign if_dec_exc_pending    = mmu_exc_pending || ill_inst || csrrf_ill;

  assign exe_exc_pending       = ecall_r || ebreak_r;

  always_comb begin
    exc_code    = exc_code_r;
    exc_pending = exc_pending_r;
    tval        = tval_r;

    unique0 case (state_r)
      ST_IF_DEC:
        if (mmu_exc_pending) begin
          exc_code    = mmu_exc_code;
          exc_pending = 1;
          tval        = pc_r;
        end else if (ill_inst || csrrf_ill) begin
          exc_code    = CAUSE_ILLEGAL_INSTRUCTION;
          exc_pending = 1;
          tval        = mmu_inst;
        end else
          exc_pending = 0;

      ST_EXE1:
        unique0 if (ecall_r) begin
          exc_code    = exc_t'(CAUSE_USER_ECALL + csrrf_priv);
          exc_pending = 1;
          tval        = 0;
        end else if (ebreak_r) begin
          exc_code    = CAUSE_BREAKPOINT;
          exc_pending = 1;
          tval        = pc_r;
        end

      ST_MEM1:
        if (misaligned_mem_access) begin
          if (load_amo_lr_r) begin
            exc_code    = CAUSE_MISALIGNED_LOAD;
            exc_pending = 1;
            tval        = mem_addr_r;
          end else if (store_amo_sc_succ || amo_rmw_r) begin
            exc_code    = CAUSE_MISALIGNED_STORE_AMO;
            exc_pending = 1;
            tval        = mem_addr_r;
          end
        end else if (mmu_exc_pending) begin
          exc_code    = mmu_exc_code;
          exc_pending = 1;
          tval        = mem_addr_r;
        end else
          exc_pending = 0;

      ST_MEM2:
        if (mmu_exc_pending) begin
          exc_code    = mmu_exc_code;
          exc_pending = 1;
          tval        = mem_addr_r;
        end else
          exc_pending = 0;

      ST_COM:
        if (misaligned_jmp) begin
          exc_code    = CAUSE_MISALIGNED_FETCH;
          exc_pending = 1;
          tval        = jmp_pc;
        end
    endcase
  end

  always_ff @(posedge clk, negedge nrst)
    if (!nrst)
      exc_pending_r <= 0;
    else begin
      exc_code_r    <= exc_code;
      exc_pending_r <= exc_pending;
      tval_r        <= tval;
    end

  /*
   * State transitions
   */
  logic if_dec_to_exe1;
  logic exe_to_com;
  logic mem1_to_com;
  logic _mem_access;

  assign if_dec_to_exe1 = iv_mul || iv_div || iv_ecall || iv_ebreak ||
    csrrf_rcsr || (_opcode == OPCODE_AMO && _funct5 == FUNCT5_AMO_SC);

  assign exe_to_com     = exe_exc_pending || !store_amo_sc_succ;

  assign mem1_to_com    = mmu_exc_pending || !amo_rmw_r;

  assign _mem_access    = _opcode == OPCODE_LOAD ||
    _opcode == OPCODE_STORE || _opcode == OPCODE_AMO;

  always_comb begin
    state = state_r;

    case (state_r)
      ST_IF_DEC:
        if (!mmu_stall) begin
          if (iv_nop || if_dec_exc_pending)
            state = ST_COM;
          else if (if_dec_to_exe1)
            state = ST_EXE1;
          else
            state = _mem_access ? ST_MEM1 : ST_COM;
        end

      ST_EXE1:
        if (mul_r) begin
          if (!mul_stall)
            state = ST_COM;
        end else if (div_r) begin
          if (!div_stall)
            state = ST_COM;
        end else
          state = exe_to_com ? ST_COM : ST_MEM1;

      ST_MEM1:
        if (misaligned_mem_access)
          state = ST_COM;
        else if (!mmu_stall)
          state = mem1_to_com ? ST_COM : ST_EXE2;

      ST_MEM2:
        if (!mmu_stall)
          state = ST_COM;

      ST_COM:
        state = misaligned_jmp ? ST_MISALIGNED_JMP : ST_IF_DEC;

      ST_MISALIGNED_JMP:
        state = ST_IF_DEC;

      default:
        state = state_t'(state_r + 1);
    endcase
  end

  always_ff @(posedge clk, negedge nrst)
    if (!nrst)
      state_r <= ST_IF_DEC;
    else
      state_r <= state;

  /*
   * MMU
   */
  logic [XLEN - 1:0]      mmu_vaddr;
  logic [XLEN - 1:0]      mmu_wdata;
  logic [XLENB_LOG - 1:0] mmu_size;
  logic                   mmu_nsign;
  access_t                mmu_access;

  assign mmu_vaddr = state_r == ST_IF_DEC ? pc_r : mem_addr_r;
  assign mmu_wdata = state_r == ST_MEM1 ? rs2_data_r : amo_rmw_data_r;
  assign mmu_size  = state_r == ST_IF_DEC ? ILENB_LOG : mem_size;
  assign mmu_nsign = funct3[FUNCT3_NSIGNSH];

  always_comb begin
    mmu_access = ACC_NONE;

    unique0 case (state_r)
      ST_IF_DEC:
        mmu_access = ACC_FETCH;

      ST_MEM1:
        if (!misaligned_mem_access) begin
          if (load_amo_lr_r || amo_rmw_r)
            mmu_access = ACC_LOAD;
          else
            mmu_access = ACC_STORE;
        end

      ST_MEM2:
        mmu_access = ACC_STORE;
    endcase
  end

  mmu MMU(
    .clk             (clk),
    .nrst            (nrst),
    .ac_vaddr        (mmu_vaddr),
    .ac_wdata        (mmu_wdata),
    .ac_size         (mmu_size),
    .ac_nsign        (mmu_nsign),
    .ac_access       (mmu_access),
    .ac_priv         (csrrf_priv),
    .ac_mstatus      (csrrf_mstatus),
    .ac_satp         (csrrf_satp),
    .ac_tlb_flush    (mmu_tlb_flush),
    .ac_icache_flush (mmu_icache_flush),
    .ac_rdata        (mmu_rdata),
    .ac_inst         (mmu_inst),
    .ac_exc_code     (mmu_exc_code),
    .ac_exc_pending  (mmu_exc_pending),
    .ac_stall        (mmu_stall),
    .asw_rdata       (asw_rdata),
    .asw_stall       (asw_stall),
    .asw_fault       (asw_fault),
    .asw_addr        (asw_addr),
    .asw_wdata       (asw_wdata),
    .asw_size        (asw_size),
    .asw_nsign       (asw_nsign),
    .asw_ren         (asw_ren),
    .asw_wen         (asw_wen),
    .cache_pte       (cache_pte),
    .cache_line      (cache_line)
  );
endmodule
