MichalBlk/vvsoc/hw/sim/flash.sv

`include "isa.svh"
`include "soc.svh"

module flash
  import isa_pkg::*;
  import soc_pkg::*;
  import board_pkg::*;
(
  input  logic                    clk,
  input  logic                    nrst,

  input  logic [FL_ADDRLEN - 1:0] asw_addr,
  input  logic                    asw_nsign,
  input  logic                    asw_ren,
  output logic [XLEN - 1:0]       asw_rdata,
  output logic                    asw_stall
);
`default_nettype none

  logic [BLEN - 1:0] mem [FLSZ - 1:0];

  initial begin
    $display("[FL] Loading OpenSBI...");
    $readmemh("opensbi.mem", mem, FL_OPENSBI_OFF);

    $display("[FL] Loading DTB...");
    $readmemh("dt.mem", mem, FL_DTB_OFF);

    $display("[FL] Loading kernel...");
    $readmemh("kernel.mem", mem, FL_KERNEL_OFF);

    $display("[FL] Loading initrd...");
    $readmemh("initrd.mem", mem, FL_INITRD_OFF);

    $display("[FL] Images loaded successfully");
  end

  /*
   * Application switch signals
   */
  assign asw_rdata = mem[asw_addr];
  assign asw_stall = 0;
endmodule
