MichalBlk/vvsoc/(commit log)

2025-01-06 [FW] Add a device tree (#9)
2025-01-06 [APP-CORE] Implement correct semantics for division by zero and division overflow (#10)
    [divisor.sv]
2025-01-15 [VCD] Support mandatory VirtIO device features (#15)
2025-01-30 [CORE] Speed up execution by merging stages (#18)
2025-02-01 [APP-CORE] Fix MMU (#19)
    [mmu.sv]
2025-02-01 [APP-CORE] Remove the finish stage from MMU (#20)
2025-02-01 [VIRTIO-SUBSYS] Limit the amount of asserted VCD interrupts (#22)
2025-02-26 Implement VirtIO GPU device (#31)
2025-03-18 [APP-CORE] Fix instruction verification post decoding stage (#33)
    [app_core.sv]
2025-04-02 [APP-CORE] Fix AMO memory address handling (#38)
    [app_core.sv]
2025-04-02 [APP-SUBSYS] Remove inferred latch from application switch (#39)
2025-05-13 Fix MMU state transitions (#44)
    [mmu.sv]
2025-05-13 [APP-CORE] Optimize MMU stalling and address handling (#45)
    [mmu.sv]
2025-05-20 Fix dts and debug console (#58)
    [app_switch.sv, top.sv]
2025-05-21 [HW] New UART controller (#59)
2025-06-02 [FW] Fix virtqueue handling (#69)
    [main.c]
2025-06-02 [HW] Fix PTE reading for Nexys A7 (#71)
    [main_memory.sv]
2025-06-06 [APP-CORW] Fix cycle counter CSR (#74)
    [csr_reg_file.sv]
2025-06-11 VirtIO keyboard device (#77)
2025-06-11 Switch to frame buffer console (#80)
2025-06-17 Remove synchronous reset from Virtio core (#83)
    [app_core.sv, main.c, reg_file.sv, top.sv, virtio_core.sv, virtio_manager.sv]
2025-06-17 [VIRTIO-SUBSYS] Merge instruction fetch and decode stages in Virtio core (#84)
2025-06-17 [APP-SUBSYS] Merge instruction fetch and decode stages in application core (#85)
2025-06-17 [APP-SUBSYS] Merge write back and completion stages in application core (#86)
2025-09-17 [HW] Fix a race between debug console and Virtio core (#91)
    [virtio_manager.sv]
2025-09-18 [VIRTIO-SUBSYS] Fix VirtIO manager notifications (#92)
    [virtio_manager.sv]
2025-09-22 [APP-CORE] Fix MRET and SRET handling (#93)
    [app_core.sv, csr_reg_file.sv]
2025-09-22 [VIRTIO-CORE] Remove execution stage from VirtIO core (#96)
2025-09-22 [VIRTIO-CORE] Remove address stage from VirtIO core (#97)
2025-09-23 [APP-CORE] Skip the MMU finish stage for loads and stores (#100)
    [app_core.sv, mmu.sv]
2025-09-24 [APP-CORE] Fix fetch page fault handling for consecutive instructions (#103)
    [app_core.sv]
2025-12-21 Increase the UART baud rate to 230400 (#114)
2025-12-21 [APP-CORE] Fix the misaligned jump state (#115)
    [app_core.sv]
2026-01-06 [HW] Fix main memory writing for the Nexys A7 (#120)
    [dram.sv]
2026-01-07 [APP-CORE] Fix FENCE.I handling (#122)
    [app_core.sv]
2026-01-13 [SIM] Fix DTB loading in simulation (#125)
    [flash.sv]
2026-01-13 [HW] Fix cache writes (#126)
    [cache.sv, main_switch.sv, top.sv]
2026-01-20 [APP-CORE] Fix exception handling (#130)
    [app_core.sv]
2026-01-21 [APP-CORE] Fix exception handling part II (#131)
    [mmu.sv]
2026-01-26 [VIRTIO-SUBSYS] Increase bit period in UART (#137)
2026-01-29 [SIM] Fix the measuring testbench (#141)
    [tb_measure.cpp]
2026-01-29 Add a reference to the UART controller (#143)
